Fablab-Plougonven/freecad-cassette-ferrotype/sources/README.md

# Sources

`hasselblad-v-mount-for-imacon-digital-back-model_files/` : « Hasselblad V mount
for Imacon digital back » de Rayfor, CC BY-NC-SA 4.0
(<https://www.printables.com/model/548055-hasselblad-v-mount-for-imacon-digital-back>).
Les cotes de l'interface ont été relevées sur `imacon_V_-_Mount-1.STL` (voir
`tools/`) ; `cad/build_cassette.py` lit la glissière et le capot d'origine pour
comparer sa version remodélisée.

Restent en local seulement (voir `.gitignore`) : les photos de référence et le dos
diascope d'OwlfotO, qui ont servi à recouper les cotes.
