Fablab-Plougonven/freecad-cassette-ferrotype/docs/COTES.md

# Dos ferrotype 5 × 5 pour Hasselblad V : cotes

Objectif : une cassette à plaque humide 57 × 57 mm pour boîtier Hasselblad 500
(même principe que la cassette Etsy « cassette à plaques humides 5 × 5 »).

Plan coté : [interface-V-cotes.png](interface-V-cotes.png)

## D'où viennent les cotes

| Source | Ce qu'on en tire | Fiabilité |
|---|---|---|
| Monture V de **Rayfor** pour dos Imacon (`sources/hasselblad-v-mount-for-imacon-digital-back-model_files`, STL) | Toute la géométrie de l'accroche : contour, crochets, verrou, gorge, poches | Bonne : testée sur un vrai boîtier avec un Imacon 132C, et reprise telle quelle par OwlfotO |
| Dos diascope d'**OwlfotO** (`sources/hasselblad-v-system-diascope-back-model_files`, 3MF) | Confirme le contour de Rayfor (plaque 90,7 × 88,85 identique). Fenêtre film 55,0 × 55,0 | Bonne |
| Forums (Pentax Forums, Photrio, Brian Smith) | Tirage mécanique 74,9 mm. Face avant du magasin → plan film **3,55 ± 0,05 mm** (cote de calibrage SAV) | Moyenne : à valider au verre dépoli |
| Photos Etsy (`sources/*.avif`) | Architecture : charnière côté crochets, couvercle avec ressort en croix, aimants aux coins, volet alu inséré **par le côté** | Qualitatif |

Licence : Rayfor et OwlfotO publient en CC BY-NC-SA 4.0. On peut remixer pour
le Fablab en citant les auteurs, mais pas vendre.

## Repère

Vue de l'arrière (côté photographe). **Haut = verrou, bas = crochets.**
Origine = centre de la fenêtre image. u vers la droite, v vers le haut.
La face d'appui est la face qui touche le boîtier.
La droite (u > 0) est le côté de la manivelle, avec le talon et les poches.

Dans le STL de Rayfor : u = 49,0 − x, v = 92,08 − z. La face d'appui est en
y = 16,22 et la face arrière en y = 9,52.

## Interface boîtier (pièce 1)

| Élément | Cote (mm) |
|---|---|
| Plaque principale | 84,4 (u ±42,2) × 86,1 (v −43,04 → +43,05), coins r ≈ 3 |
| Languette haute (côté verrou) | 64 de large (u ±32), dépasse de 2,75 (jusqu'à v +45,8), chanfreins 2,9 × 2,75 |
| Talon côté manivelle | u +42,2 → +48,5 (6,3) × 75 de haut (v ±37,5), coins r ≈ 3 |
| Encombrement total | 90,7 × 88,85 |
| Épaisseur de la plaque Rayfor | 6,7 |
| **Encoches des crochets** (bord bas) | 2 encoches de 6,5 de large, centrées à u = ±27,05 (entraxe 54,1), profondes de 1,55. Évidées sur les 5,6 arrière ; il reste une **lèvre de 1,1 côté boîtier**, que les crochets viennent prendre |
| **Fenêtres du verrou** (haut, face d'appui) | 2 fenêtres de 6,45 × 1,61, u = ±11,75 → ±18,2 (entraxe ≈ 30), v = +39,25 → +40,86 |
| Poche du verrou | u −18,2 → +26,2, v +37,25 → +44,3, de 1,0 à 4,0 de profondeur sous la face d'appui (une paroi de 1,0 reste côté boîtier). Dans la cassette : paroi ramenée à 0,8 et 0,2 de jeu par côté pour la glissière et le capot (impression d'essai du 2026-10-14) |
| Verrou coulissant (pièce `Latch`) | 40,9 × 4,7 × 11,7. Course ≈ 3,5 selon u. Languette moletée de 16,9 qui sort de ≈ 3 au-dessus du bord haut. Le dos des deux dents est une **rampe** : 0,81 d'épaisseur au bout, pleine épaisseur 6,59 plus loin (≈ 18°) ; la griffe monte dessus et plaque la cassette. Capot `LatchCover` de 56,4 × 2,4, fixé par 2 trous Ø1,8, avec deux fenêtres en face de celles des griffes. Remodélisés en esquisses (`glissiere_verrou`, `capot_verrou`), écart de volume 2 % avec les STL |
| Poche A (côté manivelle) | 3 × 17 : u +39 → +42, v +2,76 → +19,76, profonde de 5,9 depuis la face d'appui |
| Poche B (côté manivelle) | 2 × 4,5 : u +39,5 → +41,5, v −24,0 → −28,5, profonde de 5,9 |
| Gorge anti-lumière (face d'appui) | Carré intérieur 70,7 × 70,7 centré, 1,5 de large × 0,5 de profondeur, sur les 4 côtés, une seule esquisse (`gorge_cote_interieur`, `gorge_largeur`, `gorge_profondeur`). Elle **reçoit une lèvre du boîtier** : sans gorge sur le côté gauche, la pièce 1 se soulevait (essai du 2026-10-14). Avant le 2026-10-21 : 2 × 1,2, axe sur un carré de 72, profondeur du côté gauche réglable à part |
| Fenêtre de la plaque Rayfor | 61,5 × 61,5 centrée. Elle laisse entrer la **lèvre intérieure** du boîtier, autour de son ouverture. Dans la cassette (2026-10-28) : ouverture de la peau avant de 55 × 55 (`peau_ouverture`, comme la butée de la pièce 2), et une **deuxième gorge** pour la lèvre intérieure : carré intérieur 59, extérieur 61 (1 de large), 1 de profondeur (`gorge_interieure_cote_interieur`, `gorge_interieure_largeur`, `gorge_interieure_profondeur`). Il reste 2,0 de paroi entre l'ouverture et la gorge, 0,9 de peau entre le fond de la gorge et la fente du volet (contrôlés au build, 0,6 au moins). Avant : ouverture de 61,9 ; un essai à 56 sans gorge, la lèvre intérieure soulevait la pièce 1 |
| 4 trous Ø3,1, entraxe 75 × 75 | Propres à l'Imacon. À réutiliser pour assembler la pièce 1 à la pièce 2 |

Les poches A et B servent de dégagement pour les ergots et l'accouplement du
boîtier. Il faut les garder : sans elles, la cassette ne se plaque pas.

Le boîtier a **deux lèvres** à l'arrière : une intérieure, au bord de
l'ouverture, qui entre dans la deuxième gorge (carré 59 → 61, 1 de profondeur), et une entre le bord et
l'intérieur, qui entre dans la gorge de 2 × 1,2 (carré de 72). Leurs hauteurs
n'ont pas été mesurées : la lèvre intérieure doit rester sous 1 (fond de sa
gorge), sinon la pièce 1 se soulève.

## Plan film et empilement (pièces 1 et 2)

L'émulsion est à **3,55 derrière la face d'appui** (validé). De l'avant vers
l'arrière :

| Couche | Profondeur depuis la face d'appui | Épaisseur |
|---|---|---|
| Peau avant de la pièce 1, ouverture 55 × 55, gorge de la lèvre intérieure 59 → 61 sur 1 (il reste 0,9 de peau devant la fente ; à gauche, sous la fente, 0,7 au-dessus de la gorge extérieure) | 0 → 1,9 | 1,9 |
| Fente du volet, entre la peau et les rails de la pièce 2 | 1,9 → 2,3 | 0,4 |
| Butée de la pièce 2, ouverture 55 × 55 (1 d'appui par côté) | 2,3 → 3,55 | 1,25 |
| Plaque 57 × 57, de 1 à 3 d'épaisseur, dans un logement de 57,4 | 3,55 → 4,55 à 6,55 | 1 à 3 |
| Ressort en croix : bossage fraisé (Ø10 × 1,2) à 0,3 au-dessus du verre le plus épais, moyeu et bras au-dessus, pieds écrasés de 1,5 (verre de 1) à 3,5 (verre de 3) | 6,85 → 9,05 | 2,2 au moyeu, 1,0 aux bras |

## Volet

- Inséré **par la gauche** (u < 0), comme sur le Hasselblad. Par le haut il
  traverserait la poche du verrou, imposée par le boîtier.
- Fente borgne jusqu'à u = +30,9, de 66,38 × 0,4, pour la plaque métal mesurée à
  65,88 de large (0,5 de jeu), épaisse de 0,35 au plus.
- Velours à l'entrée, sur la peau de la pièce 1 et sur la pièce 2.

## Étanchéité entre les pièces

- **Chicane de la collerette** : nervure en U de 0,6 × 0,8 sous la collerette
  de la pièce 2, dans une gorge de 1,0 × 1,0 à l'arrière de la pièce 1, à 36,1
  du centre, en haut, en bas et à droite. Le bossage de la charnière descend à
  −37,5 pour la laisser passer.
- **Chicane des rails** : nervure de 0,5 × 0,5 sous les rails du volet et sa
  butée de fond, dans une gorge de 0,9 × 0,6 du fond de la poche de la pièce 1.
  Elle coupe le chemin de la lumière qui longerait l'insert depuis le bord
  gauche jusqu'à la fente.
- **Couvercle** : deux nervures de 1,0 × 0,8 dans deux gorges de 1,6 × 1,0 de la pièce 2, et une paroi qui ferme la face de la charnière.
- Les fenêtres des griffes, en haut, sont hors de la zone étanche (au-delà de
  la lèvre du boîtier) ; la collerette de la pièce 2 a un dégagement en face
  d'elles, au cas où les griffes dépassent du capot.

## Fermeture du couvercle

- Couvercle plein dans le prolongement des pièces (2026-10-21) : contour de la
  pièce 2 (plaque et talon), 7,4 de haut au-dessus d'elle (`couvercle_hauteur`),
  posé à plat sur toute sa face arrière, sans rien qui descende sur les côtés :
  on ouvre volet en place. Plein pour la matière contre la transparence du
  PETG : il n'est creusé que d'une chambre ronde pour le ressort (rayon 27,5,
  jusqu'à z 13,05 : bras soulevés de 3,5 + 0,5), des nervures, des logements
  d'aimants et d'un dégagement de 2,5 × 2,8 au-dessus du nœud central de la
  charnière. 4,45 de matière au-dessus de la chambre (5,65 avec le ressort collé, avant le 2026-11-04). Cassette de 17,5
  d'épaisseur avec des aimants de 2 mm (pièce 2 à 3,4 : logement de 2,3 et 1,1 dessous).
- Deux nervures de 1,0 × 0,8 dans deux gorges de 1,6 × 1,0 de la pièce 2
  (axes 33,5 et 30,7), autour de la chambre du ressort.
- Charnière côté crochets, axe Ø2. Le bloc du nœud central de la pièce 1 est
  hors de la cassette, sous la pièce 2 (jeu 0,4), tenu par le gousset à 45° :
  il laisse tourner le couvercle. La pièce 2 n'a plus de dégagement.
- Fermeture par aimants collés : deux paires Ø6 × 2 dans les coins opposés à
  la charnière, x ±35,3, y 38,675. En y, au milieu de la bande entre la gorge
  extérieure (34,3) et le bord haut (43,05) : 1,17 de paroi de chaque côté, le
  maximum. En x, au plus loin du bord latéral (3,7) que permet la fraisure de la
  vis du haut (1 de paroi). Logements ouverts sur les faces de joint (2026-11-11,
  à la place des aimants incrustés sous une peau de 0,4 avec pause d'impression) :
  Ø6,4 (jeu 0,4) × 2,3 (aimant + 0,3 de retrait pour la colle, l'aimant ne dépasse
  pas) ; 0,6 entre les aimants couvercle fermé. Collerette de la pièce 2 =
  logement + 1,1 (3,4 avec des aimants de 2, inchangée) : elle suit l'épaisseur
  des aimants, la cassette aussi (15,5 + épaisseur de l'aimant).
  Tailles essayées au build : Ø5 × 1, Ø6 × 2, Ø7 × 3, Ø6 × 4 bonnes ; Ø8
  refusée (0,27 de paroi vers la gorge et le bord haut ; le build exige 0,6).
  Vis : deux dans les coins du bas (x ±38, y −39 : 0,9 de paroi entre la
  fraisure et les bords, contre 0,44 en v0.1), une en haut à gauche du verrou
  (x −28), une sur le talon droit
  (44, 28), M3 × 8.
- Assemblage FreeCAD : liaison pivot de la charnière, butée à 140° (le couvercle
  plein touche le gousset de la pièce 1 vers 168° avec des aimants de 2 mm,
  151° avec 3 mm : la pièce 2 s'épaissit et la charnière monte d'autant). Le build vérifie que la liaison est
  bien la charnière modélisée, puis ouvre le couvercle degré par degré de 0 à
  30°, de 2 en 2 au-delà, volet en place : aucune collision.
- Clips abandonnés (2026-10-21) : plus d'ergots sur le talon de la pièce 1. Le couvercle de test
  pour les pièces de la v0.1 (`tools/lid_for_v0_1.py`) garde les clips.
- Ressort pour des verres de 1 à 3 mm (`verre_epaisseur_min`, `verre_epaisseur_max`) :
  bras de 27 × 6 × 1, pieds Ø5 au bout. Écrasement 1,5 sur le verre le plus fin,
  3,5 sur le plus épais ; le bout des bras monte alors jusqu'à z 12,55, dans le
  logement du verre, sans toucher la pièce 2 ni le couvercle (vérifié au build).
  Force estimée (PETG, E ≈ 2 GPa) : environ 4 N sur un verre de 1, 8 à 9 N sur
  un verre de 3, que les deux paires d'aimants doivent retenir : à vérifier à
  l'essai. Déformation maximale des bras environ 1,8 %.
- Ressort vissé (2026-11-04), à la place du pion Ø3 et de la colle : insert M3
  à chaud M3 × 5,7 (type Ruthex, trou Ø4 × 6,2 depuis le bout du tenon Ø8 :
  2,0 de paroi, 2,25 de matière au-dessus du trou), vis M3 × 6 à tête fraisée
  par le côté du verre. La tête se loge dans un bossage Ø10 × 1,2 sous le moyeu
  (fraisure Ø6,2 à 90°, passage Ø3,4), imprimé côté pieds : la face plate du
  ressort reste sur le plateau. Le bossage garde 0,3 au-dessus du verre le plus
  épais ; le ressort monte donc de 1,2 (pieds de 5 au lieu de 3,8), et la
  chambre du couvercle aussi. Le build vérifie 3,8 de filet en prise dans
  l'insert, 2,4 entre le bout de la vis et le fond du trou, et que vis et
  insert ne touchent ni le ressort, ni le couvercle, ni le verre le plus épais.

## Verrou

- Repris de Rayfor : fenêtres, poche, glissière à rampe, capot. La pièce 1
  laisse 0,2 de jeu par côté (`latch_fit`), la paroi devant la glissière fait
  0,8 (1,0 était trop épais à l'essai).
- Le capot affleure l'arrière de la pièce 1 et c'est la collerette de la pièce 2
  qui le tient : pas de vis.
- Ressort de compression Ø2 × 10 (2026-10-28), dans la poche sous la glissière,
  entre sa dent gauche et l'îlot (le taquet) : il pousse la glissière vers la
  position verrouillée. Avec l'îlot de Rayfor (bord gauche à 2,75), il restait
  11,7 entre la dent et le taquet glissière verrouillée : le ressort flottait
  (essai du 2026-10-28). Le bord gauche de l'îlot est maintenant calculé
  (`verrou_ilot_gauche` = −0,45) pour que le ressort fasse 9 verrouillé
  (écrasé de 1, `ressort_verrou_precharge`) et 5,5 déverrouillé (course 3,5).
  Le build vérifie que le ressort touche la dent et le taquet dans les deux
  positions, sans rien traverser. Le ressort se comprime bien jusqu'à 5,5
  (vérifié sur le ressort le 2026-10-28).
- Derrière la lèvre des crochets, 5,6 de vide sur la largeur des encoches : ni
  charnière ni couvercle à cet endroit.

## Validé

- Plan film à 3,55, plaque de 57 × 57 × 1, volet de 65,88 de large.

## À vérifier sur le boîtier

1. Hauteur et largeur des deux lèvres du boîtier.
2. Longueur des griffes : dépassent-elles du capot ?
3. Netteté au verre dépoli.
