Fablab-Plougonven/freecad-cassette-ferrotype/docs/interface-V-cotes.png

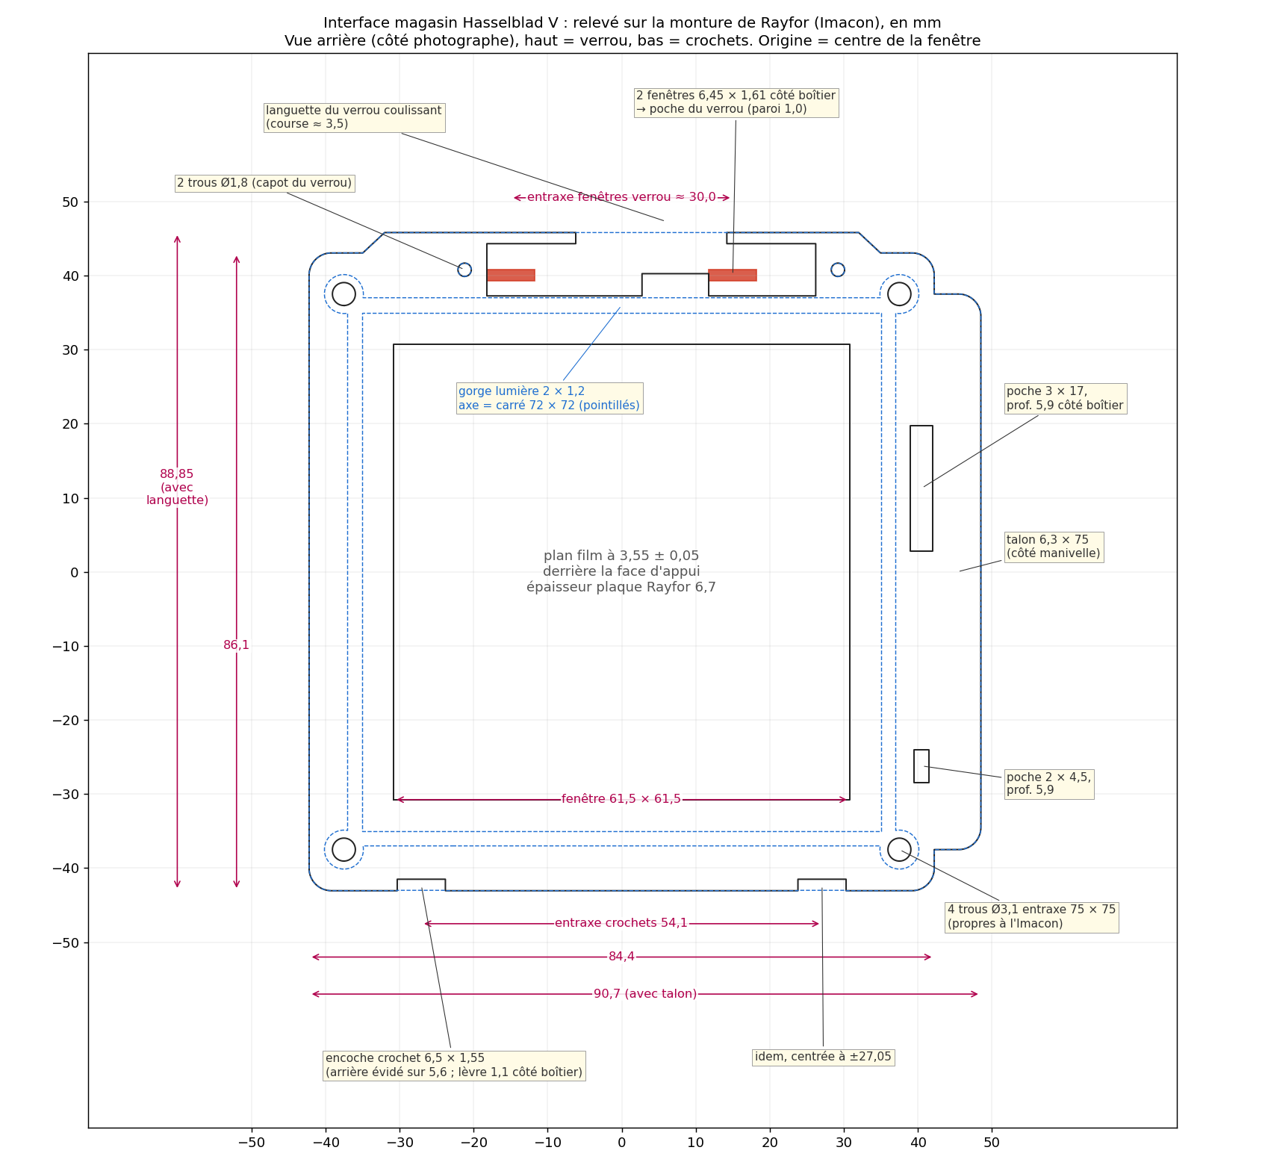
docs/interface-V-cotes.png
