Fablab-Plougonven/freecad-cassette-ferrotype/sources/hasselblad-v-mount-for-imacon-digital-back-model_files/imacon_V_-_Mount-1.STL

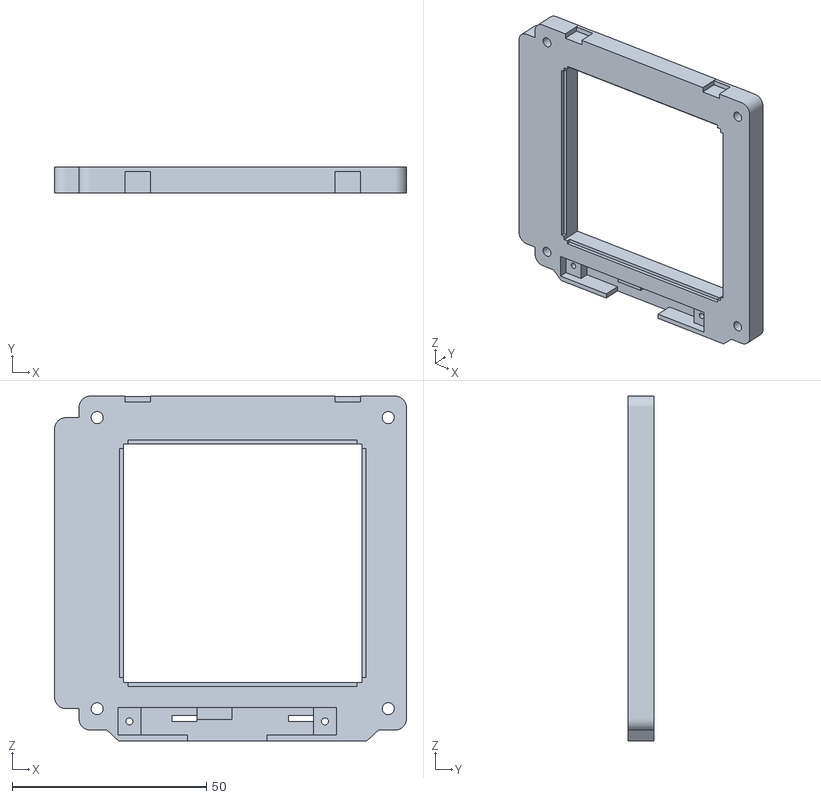
[picture p4: CAD file, 2026-10-14]
sources/hasselblad-v-mount-for-imacon-digital-back-model_files/imacon_V_-_Mount-1.STL
90.7 x 6.70 x 88.8
