Fablab-Plougonven/freecad-cassette-ferrotype/sources/hasselblad-v-mount-for-imacon-digital-back-model_files/imacon_V_-_LatchCover-1.STL

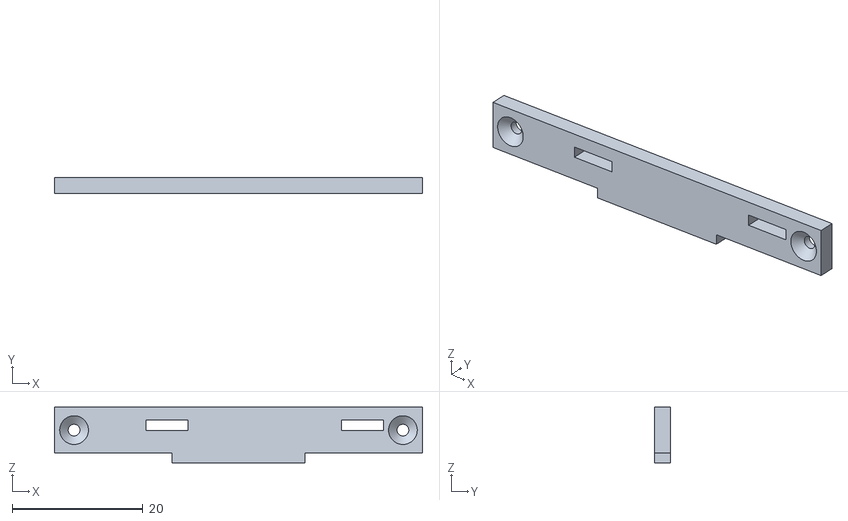
[picture p5: CAD file, 2026-10-14]
sources/hasselblad-v-mount-for-imacon-digital-back-model_files/imacon_V_-_LatchCover-1.STL
56.4 x 2.40 x 8.55
