Fablab-Plougonven/freecad-cassette-ferrotype/sources/hasselblad-v-mount-for-imacon-digital-back-model_files/imacon_V_-_Latch-1.STL

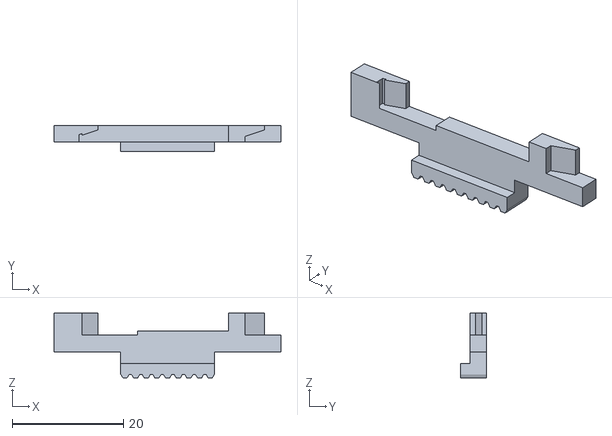
[picture p6: CAD file, 2026-10-14]
sources/hasselblad-v-mount-for-imacon-digital-back-model_files/imacon_V_-_Latch-1.STL
40.9 x 4.70 x 11.7
