Fablab-Plougonven/freecad-cassette-ferrotype/sources/hasselblad-v-mount-for-imacon-digital-back-model_files/548055-hasselblad-v-mount-for-imacon-digital-back-e38ddf1f-3a02-4c66-927f-3229410f923f.pdf

## Hasselblad V

## mount for Imacon

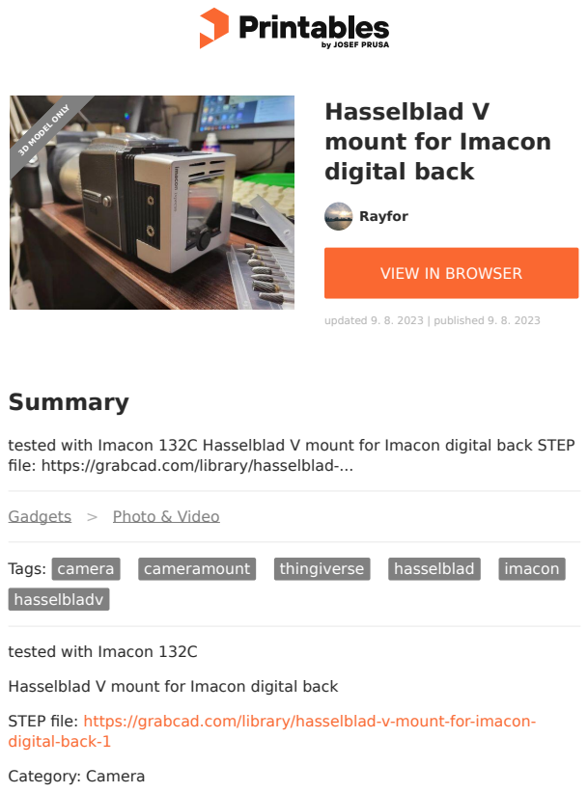
[picture p7: page 1]
Summary; Gadgets; Photo & Video; Tags: camera; cameramount; thingiverse; hasselblad; imacon; hasselbladv; Category: Camera; Rayfor; digital back; updated 9. 8. 2023 | published 9. 8. 2023; 3D MODEL ONLY

VIEW IN BROWSER (https://printables.com/model/548055-hasselblad-v-mount-for-imacon-digital-back)

tested with Imacon 132C Hasselblad V mount for Imacon digital back STEP
file: https://grabcad.com/library/hasselblad-...

tested with Imacon 132C

Hasselblad V mount for Imacon digital back

STEP file: https://grabcad.com/library/hasselblad-v-mount-for-imacon-
digital-back-1 (https://grabcad.com/library/hasselblad-v-mount-for-imacon-digital-back-1)

# Model files

Find source .stl files on Thingiverse.com (https://www.thingiverse.com/thing:5442026)

## License

This work is licensed under a

Creative Commons (4.0 International License)

Attribution—Noncommercial—Share Alike (http://creativecommons.org/licenses/by-nc-sa/4.0/)

✖ | Sharing without ATTRIBUTION
✔ | Remix Culture allowed
✖ | Commercial Use
✖ | Free Cultural Works
✖ | Meets Open Definition

imacon_v_⁻_latchcover-1.stl

imacon_v_⁻_mount-1.stl

imacon_v_⁻_latch-1.stl
