Fablab-Plougonven/freecad-cassette-ferrotype/docs/coupes-assemblage.png

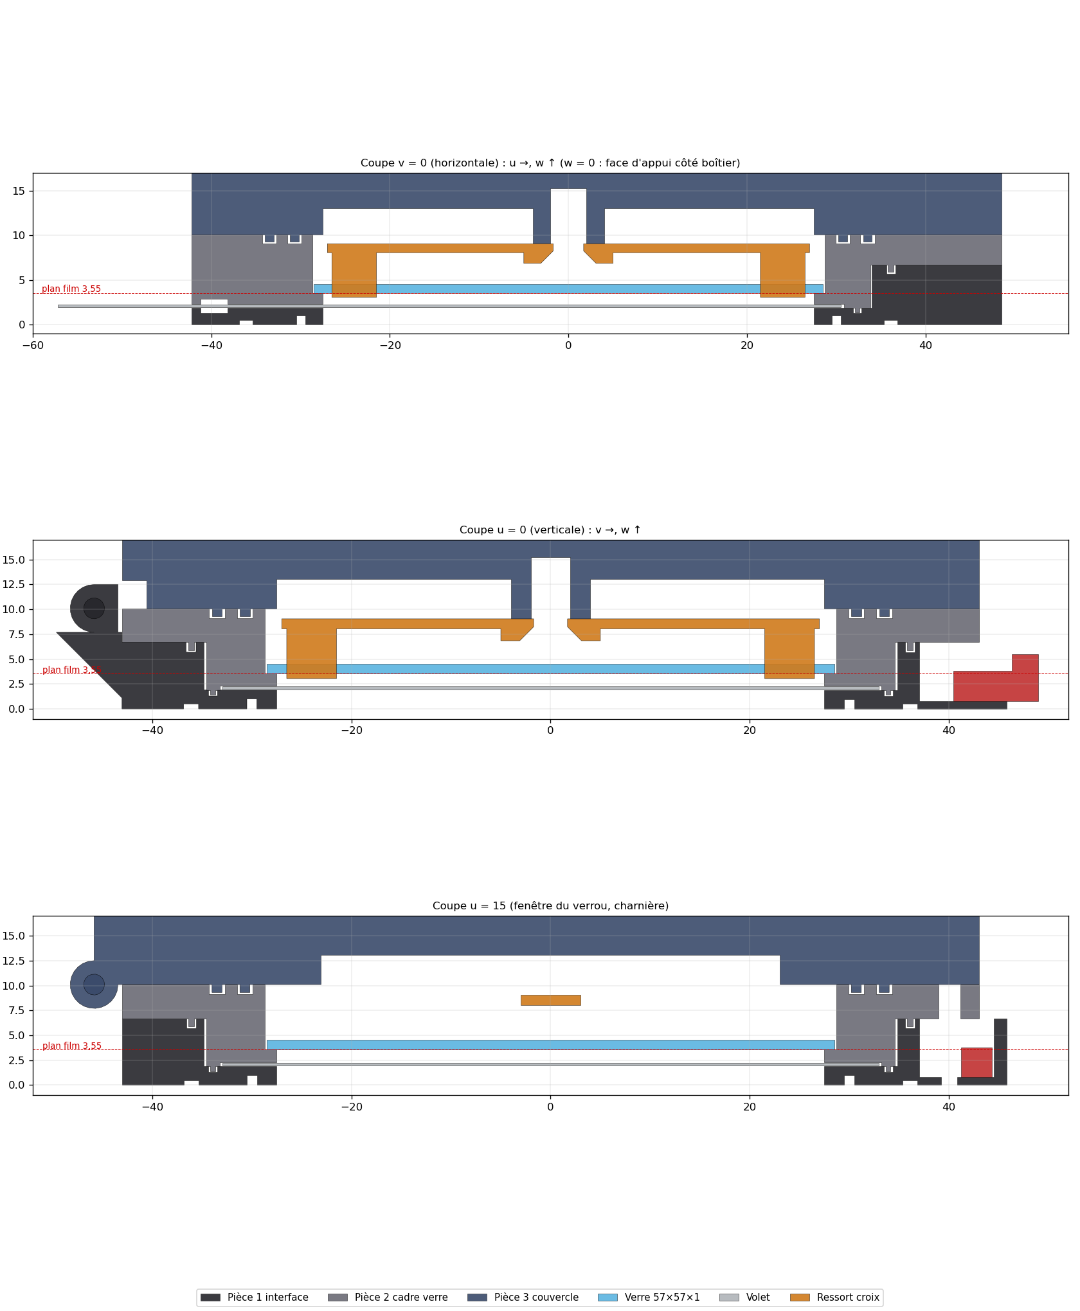
docs/coupes-assemblage.png
