Fablab-Plougonven/freecad-cassette-ferrotype/(commit log)

2026-10-14 Wet-plate cassette 57x57 for Hasselblad V, parametric FreeCAD model
    Sketch-based PartDesign model (65 fully constrained sketches driven by the
    Parametres sheet), generated and checked by cad/build_cassette.py:
    interface piece, glass frame, hinged lid with two clips, cross spring,
    and the Rayfor latch slider and cover remodelled from their STL.
    Exports are published as release assets, not versioned.
    [imacon_V_-_Latch-1.STL, imacon_V_-_LatchCover-1.STL, imacon_V_-_Mount-1.STL, parameters.csv]
2026-10-21 Box lid, magnet closure, assembly joints; model rebuilt the PartDesign way
    - Every piece rebuilt as a hand-made PartDesign tree: named datum planes,
    pockets to real depths, Hole features with countersinks, Mirrored and
    Linear/Polar patterns, no 0.01 overlaps. Sketches dimensioned like a
    drawing (named widths, heights, diameters, symmetries) driven by the sheet.
    - Sheet parameters renamed in clear French (x left/right, y bottom/top,
    z depth); mating-face groove 70.7 inside, 1.5 wide, 0.5 deep, one sketch.
    - Lid as a box: top set back 5 mm, skirt down to the body on top and right,
    above the dark slide slot on the left (opens with the slide in), wall
    closing the hinge side, frame be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
    [parameters.csv]
2026-10-21 Drop the clips, take glass from 1 to 3 mm, softer long-travel spring
    - Magnets are the only closure: no clip stops on piece 1, the right skirt
    of the lid at 0.3 from the heel like the other sides; variant switch and
    *_clips exports removed.
    - Glass thickness from verre_epaisseur_min to verre_epaisseur_max (1 to
    3 mm): spring hub above the thickest glass, feet squeezed 1.5 to 3.5 mm,
    arms 27 x 6 x 1 so the force stays moderate. The build checks that only
    the feet touch both glasses and that the lifted arms have room.
    - tools/lid_for_v0_1.py builds with the model of 411fa5c (last one with
    clips), so the lid for v0.1 pieces stays reproducible.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
    [parameters.csv]
2026-10-21 Solid lid in line with the pieces, no skirt
    The lid now continues the outline of piece 2 (plate and heel), 7.4 mm high,
    bearing flat on its rear face with nothing covering the sides: it opens
    with the dark slide in. It is solid against the translucency of PETG and
    hollowed only for the spring chamber (arms lifted on a 3 mm glass), the
    two ribs, the magnet seats and a clearance over the central knuckle; 5.25
    mm of material above the chamber. Hinge stop at 160 deg (the solid lid
    touches the gusset of piece 1 at 168 deg). Skirt, notch and wall
    parameters removed.
    [parameters.csv]
2026-10-21 Embedded magnets, 0.2 clearance, as far from the edges as possible
    - Magnets embedded in closed seats (6.2 x 2.2, clearance 0.2) under a 0.4
    skin on the joint side, dropped in during a print pause: piece 2 at
    2.60 mm (rear face down), lid at 7.00 mm (outer face down); 1.0 mm
    between the magnets when closed. Flange of piece 2 now 3.4 mm.
    - Seats moved to x +-35.2: centred in the band between the outer groove
    and the top edge (1.28 each side, the most there is) and 3.9 from the
    side edge, 1 mm from the countersink of the top screw.
    - The build checks the magnets sit inside their cavities with 0.8 mm over
    them and prints the pause heights; README gives the polarity rule.
    Co-Authore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
    [parameters.csv]
2026-10-21 Bottom screws back in the corners; magnet size free within checked margins
    - Bottom screws at (+-38, -39): symmetric, in the corners freed by the
    magnets, 0.9 mm of wall around the countersinks (0.44 in v0.1).
    - Piece 2 flange follows the magnet (skin + magnet + clearance + 0.8), so
    the magnet thickness can change; spring chamber ceiling kept 0.5 above
    piece 2 (max() in the sheet, ';' handled by the Python evaluator).
    - The build checks the walls around the magnet seats (0.6 minimum).
    Tried: 5x1, 6x2, 7x3, 6x4 pass; 8 mm refused (0.27 mm walls).
    - Hinge stop 140 deg: thicker magnets raise the hinge, and the solid lid
    meets the gusset at 151 deg with 3 mm magnets.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
    [parameters.csv]
2026-10-21 Views of the current cassette; release tags the built commit
    - docs/vue-*.png regenerated: solid lid, magnets, no joint markers; the
    exploded view moves copies (the assembly joints put the originals back).
    - tools/release.sh tags the commit that was built (--target), not the
    default branch, and publishes the lid for v0.1 pieces too.
2026-10-28 Sliding captive lid, leaf spring, 55 opening, inner lip groove, latch spring
    - Piece 1: opening 55 x 55, second groove for the inner lip of the body
    (59 -> 61, 1 deep); latch island widened so the 2 x 10 spring stays
    compressed (9 locked, 5.5 unlocked); hinge removed; holes of the stop pins.
    - Lid slides to the right on two dovetail rails of piece 2, captive behind two
    2 mm pins; the sole runs in a channel over the glass; light traps: tongue in
    each rail, left lip from rail to rail capped by a rebate, tongue in a slot,
    right lip (closing stop). Dovetail play 0.1.
    - Leaf spring (printed part glued under the lid) replaces the cross spring:
    pads chamfered at 45 deg climb the steps b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
    [parameters.csv]
2026-11-04 Back to the hinged lid; cross spring screwed into an M3 insert
    Reverts the sliding lid of 151d533 to the hinged lid of v0.2, keeping what
    was independent of it.
    - Kept from 151d533: piece 1 opening 55 x 55 with a second groove for the
    inner lip of the body (59 -> 61, 1 deep); latch island computed for the
    2 x 10 latch spring (9 locked, 5.5 unlocked) and its checks.
    - Cross spring held by an M3 x 6 countersunk screw in a heat-set insert
    M3 x 5.7 (hole 4 x 6.2 in the lid tenon) instead of the glued pin: a 10 x 1.2
    countersunk boss under the hub, printed on the feet side; the spring and
    the lid chamber move up 1.2 (4.45 of lid above the chamber).
    - Checks: thread engagement, tip clea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
    [parameters.csv]
2026-11-04 Print plate: Bambu Studio 3MF with the six pieces, magnet pauses, in the release
    - tools/plateau.py: each piece turned with its visible or largest flat face on
    the bed, laid on z = 0, placed on the X1 Carbon plate clear of the excluded
    corner; a Bambu Studio project 3MF (per-object walls and infill, the two
    magnet pauses in custom_gcode_per_layer.xml) and the laid STL.
    - cad/bambu/project_settings.config: X1 Carbon 0.4, 0.16mm Optimal,
    textured PEI, Bambu PETG Basic black, written by Bambu Studio's CLI.
    - tools/release.sh builds the plate and publishes cassette_ferrotype.3mf.
    - README: print plate section; the latch cover prints visible face down.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
2026-11-11 Glued magnets in open seats, no print pause; two plates (black PLA case, green PETG spring and latch)
    - Magnet seats open on the joint faces of piece 2 and the lid: 6.4 x 2.3
    (0.4 clearance, 0.3 recess for the glue), 0.6 mm apart lid closed;
    piece 2 keeps its 3.4 collar.
    - tools/plateau.py writes two Bambu Studio projects, each with its presets:
    cassette_boitier.3mf (pieces 1, 2, lid; PLA Basic black, 0.16 Optimal) and
    cassette_ressort.3mf (spring, slider, cover; PETG Basic green, 0.12 Fine).
    No plate STLs, no pauses.
    [parameters.csv]
